fabioitturriet/32F769IDISCOVERY-Communication_with_ADS1198/ECG/TouchGFX/assets/images/__designer/Dark_Backgrounds_Main_bg_texture_480x272px.png

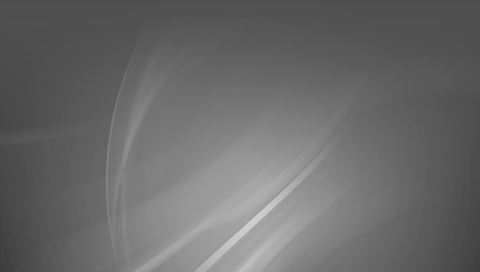
ECG/TouchGFX/assets/images/__designer/Dark_Backgrounds_Main_bg_texture_480x272px.png
