fabioitturriet/32F769IDISCOVERY-Communication_with_ADS1198/README.md

# Integração da Plataforma de desenvolvimento STM32F769IDISCO com o CI ADS1198
Autores: Fábio Itturriet e Patrick Morás
Data: 30/03/2022 
Versão: STM32CubeIDE 1.9.0 TouchGFX 4.19.0

_________________________________________________________________________________________________________________________________________________________________________________
# Importando o projeto

1. Faça download da pasta **ECG**, é preferível que ela seja salva na pasta raiz como C:\STM32Workspace\ECG.

Execute o STM32CubeIDE para importar o projeto

**Importante**: Ao selecionar o espaço de trabalho do CubeIDE, prefira por caminhos sem espaço pois podem gerar comflitos 
1. No CubeIDE vá atá a aba File > Import...
2. Selecione Existing Projects into Workspace > Next
3. Selecione Select root diretory > clique em browse... e selecione a pasta do projeto criado no touchGFX
4. Na área de "Projects:" será reconhecido o diretório do projeto para o STMCube, marque-o e clique em "Finish" 



Por ora, a integração esta completa, mas é interessante fazer algumas alterações para facilitar a manipulação do projeto. Para se ter um acesso direto ao arquivo do projeto da tela no cubeIDE, basta ir até a pasta que contém o projeto, acessar a pasta TouchGFX, clicar e segurar no executável do projeto, arrasta-lo para o cubeIDE e soltá-lo no projeto impotado na aba "Project Explorer"



Selecione "Link to files" e clique em "OK"



dessa maneira o executável do TouchGFX fica de fácil acesso para fazer alterações.

**Importante**: Ao compilar o código pode ocorrer erro como o da figura abaixo.



Isto ocorre pois a biblioteca do TouchGFX não está no mesmo caminho em que o projeto foi criado originalmente. Logo este caminho deve ser atualizado conforme o local da área de trabalho utilizada para importar o projeto. 
Para isto basta ir em Project -> Properties -> C/C++ General -> Paths and Symbols -> Library Paths, e alterar o caminho para a pasta /gcc do projeto 



### Configuração do Debugger

Antes de executar o código na plataforma deve configurar o Debugger. Com a plataforma conectada:

1. Execute o CubeIDE e vá na guia Run > Debugger configuration...
2. clique na aba Debugger e role até o final na janela
3. Marque "External Loader" e clique em scan
4. Por fim ao lado de Scan selecione a plataforma que esta sendo usada, aplique as configurações e feche a janela, ou execute o Debugger como desejado



Obs.: quando não feito esta configuração, ao executar o código a placa muitas vezes não é reconhecida adequadamente e sugem artefatos na tela assim como a falta de componentes graficos que deveriam estar lá.

### Importando uma GUI no TouchGFX 
 
 Abrindo o arquivo TouchGFX do projeto é possivel importar uma GUI ja existente em outro projeto
 1. Para isto basta ir na aba Edit > Import GUI 
 
 
 
 2. Clique em **Browse** e procure pelo arquivo que contém a GUI que se deja importar
 
 

3. Será exibido que ao importar a GUI atual será discartada e não será possível reverter esse processo, prossiga caso esteja seguro
4. Será indicado que a GUI importada possui alterações externas, basta clicar em Não nessa janela e finalmente temos a GUI importada, pode-se então gerar o código que será atualizado no projeto atual.

Ao importar a GUI de um outro projeto, como nesse exemplo, a função de importação importa apenas arquivos que estão localizados nas pastas gui/ e assets/. É importante destacar que para realizar a importação as versões dos projetos TouchGFX devem ser as mesmas, caso o projeto que se deseja importar está numa versão antiga do TouchGFX, para atualizado para nova versão basta abri lo com o TouchGFX e salva lo.

_________________________________________________________________________________________________________________________________________________________________________________
# Descrição dos pinos do ADS1198 conectados a plataforma versão 2.0

| Pino do ads1198 | Função (lado do ADS1198) | Descrição | Pino correspondente disco-F769NI |
| --- | --- | --- | --- |
| CLKSEL | entrada digital | Seleciona o fornecimento de clock principal (interno ou externo) | PB_14 (D12) |
| DRDY# | saída digital | Dados prontos, ativo baixo, depende do modo usado (RDATAC ou RDATA) | PF_6 (D3) |
| GPIO4 | saída/entrada digital | Pino de entrada / saída de uso geral configuráveis através de registradores; saida: registrador GPIOD define o valor da saída; entrada: multiplexado com o sinal de RESP_PH* (nao Configurado)| PB_15 (D11) |
| GPIO3 | saída/entrada digital | Pino de entrada / saída de uso geral configuráveis através de registradores; saida: registrador GPIOD define o valor da saída; entrada: multiplexado com o sinal RESP* (nao configurado) | PA_11 (D10) |
| GPIO2 | saída/entrada digital | Pino de entrada / saída de uso geral configuráveis através de registradores saida: registrador GPIOD define o valor da saída; entrada: multiplexado com sinal RESP_BLK* (nao configurado) | PH_6 (D9) |
| DOUT | saída digital | Saída de dados SPI, funciona juntamente com o SCLK | PF_8 (A4) SPI5_MISO |
| GPIO1 | saída/entrada digital | Pino de entrada / saída de uso geral configuráveis através de registradores saida: registrador GPIOD define o valor da saída; entrada: multiplexado com o sinal PACEIN* (nao configurado)| PJ_4 (D8) |
| DAISY_IN | Entrada digital | Utilizado quando se quer frontends funcionando em cadeia; curto com o DGND caso não utilizado | PC_8 (D5) |
| SCLK | Entrada digital | Clock SPI* | PF_7 (D6) SPI5_SCLK |
| CS# | Entrada digital | Seleção de chip para comunicação SPI,  ativo baixo durante toda a comunicação, após o fim da comunicação esperar pelo menos 8 ciclos de TCLK para subir o nível lógico, quando ocorrer a borda de subida a interface serial é reiniciada | PJ_0 (D4) |
| START | Entrada digital | Iniciar conversão, ativo alto por pelo menos dois TCLK, ou o comando START enviado para iniciar a conversão, sem o comando e o START em nível lógico baixo DRDY não emite sinal (conversões são interrompidas). utilizando o comando, o pino Start deve ficar em nivel lógico baixo (utilizado dessa maneira por enquanto). | curto com DGND |
| RESET# | Entrada digital | Reinicia o sistema, leva 18 ciclos para reiniciar (podendo voltar para o sinal alto), para reiniciar pode-se utilizar o comando RESET (entra em vigor na oitava borda descendente do SCLK) (utilizado o comando por enquanto) | PC_2 (A2) |
| PWDN# | Entrada digital | Desliga todos os circuitos do chip, é recomendado que durante o desligamento o relógio externo tbm seja desligado para economizar energia, | PA_4 (A1) |
| DIN | Entrada digital | Entrada de dados SPI* | PF_9 (A5) SPI5_MOSI |

_________________________________________________________________________________________________________________________________________________________________________________
## Alimentação

A alimentação digital (DVDD) tem 3,3V e a alimentação analógica (AVDD) tem 5V. Nesta configuração a tensão de referência fornecida ao integrado deve ser de 4V, ao contrário dos 2,4V recomendados para quando o CI é alimentado com tensão analógica menor do que 5V. Uma tensão de referencia maior faz com que resolução do CI diminua porém na tabela a seguir notamos que a tensão máxima de entrada digital no CI é de DVDD+0.1 V. Nesse sentido, a que a tensao digital utilizado na plataforma de desenvolvimento é 3.3V, para não ser necessário a utilização uma interface de regulação de tensao entre o CI e a plataforma foi utilizado, como ja comentado, 3,3V para alimentação digital o que resulta numa elevação da alimentação analógica (para 5V).



Em sintese AVDD foi definido como 5V e DVDD para 3.3V, dessa maneria não são necessários divisores de tensão na interface entre o ADS e o MCU, reduzindo a complexidade do circuito.

_________________________________________________________________________________________________________________________________________________________________________________
## Configurações

Foi utilizado o SPI5 para comunicação com o ADS, o clock fornecido para SPI5 é pelo barramento APB2 que pode ter 108 MHz (max).



O mínimo periodo para SCLK é 50ns, ou seja é um maximo de 20MHz de frequência, inicialmente foi utilizado o prescaler do SPI5 para diminuir a frequência 12.5MHz. No manual do ADS1198 também vemos outra configurações que devem ser feitas: NOTE: SPI settings are CPOL = 0 and CPHA = 1.



_________________________________________________________________________________________________________________________________________________________________________________
# Links importantes

https://www.youtube.com/watch?v=MUZj4YwKVac -> Adicionando biblioteca no cubeIDE

https://www.youtube.com/watch?v=x_5rYfAyqq0 -> SPI e DMA 

https://e2e.ti.com/support/data-converters-group/data-converters/f/data-converters-forum/252003/ads1298-signals-offset -> Ajuste de offset para cada canal

https://www.youtube.com/watch?v=Zqwq9nzTNF8 -> Recursos avançados de depuração: SWV

_________________________________________________________________________________________________________________________________________________________________________________
#  Versão 3.0

- Retirada do curto entre AVSS e DGND nos pinos 32 e 33 respectivamente.
- Pace_outP e Pace_outN expostos para processos de calibração
