fabioitturriet/32F769IDISCOVERY-Communication_with_ADS1198/ECG/TouchGFX/assets/images/local_eletrodos_corpo.png

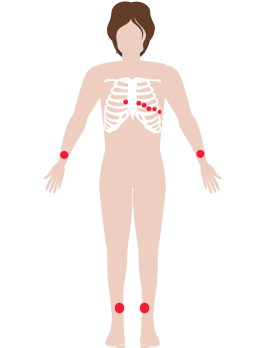
ECG/TouchGFX/assets/images/local_eletrodos_corpo.png
