fabioitturriet/32F769IDISCOVERY-Communication_with_ADS1198/ECG/TouchGFX/assets/images/VersaoVertical_resized.png

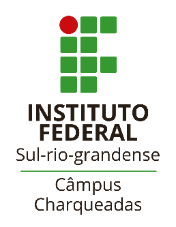
ECG/TouchGFX/assets/images/VersaoVertical_resized.png
