fabioitturriet/32F769IDISCOVERY-Communication_with_ADS1198/imgs/PCB_Frontend_ECG.png

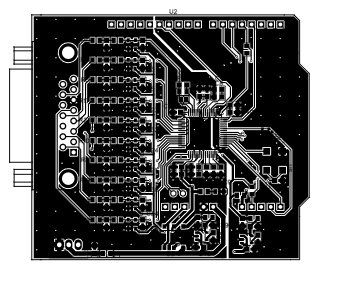
imgs/PCB_Frontend_ECG.png
