fabioitturriet/32F769IDISCOVERY-Communication_with_ADS1198/imgs/schematic_Frontend_ECG.png

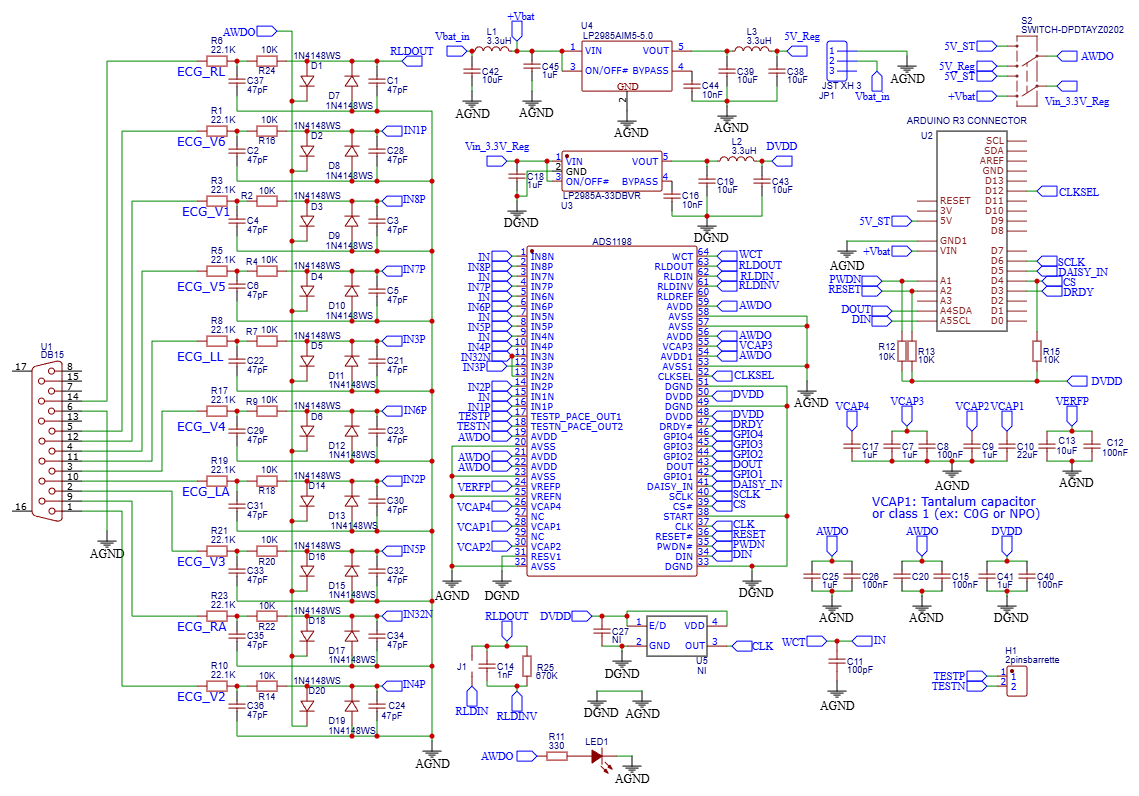
imgs/schematic_Frontend_ECG.png
