fabioitturriet/32F769IDISCOVERY-Communication_with_ADS1198/imgs/schematic_Frontend_ECG.pdf

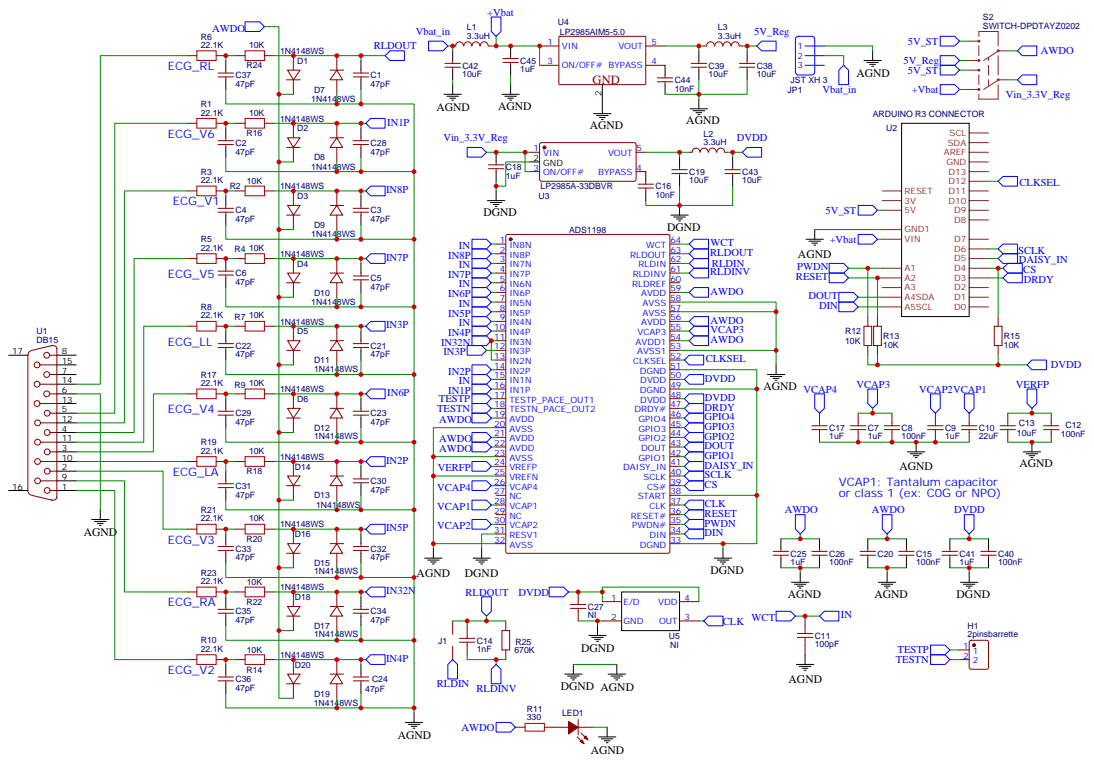
[picture p11: page 1]

VCAP1: Tantalum capacitor
or class 1 (ex: C0G or NPO)
AWDO
