fabioitturriet/32F769IDISCOVERY-Communication_with_ADS1198/ECG/STM32F769I_DISCO.ioc

Mcu.UserName=STM32F769NIHx
PA0/WKUP.Signal=GPXTI0
PA10.Signal=USART1_RX
PA4.GPIO_Label=PW_KEY
PA4.Signal=GPIO_Output
PA9.Signal=USART1_TX
PB14.GPIO_Label=ADS_CLKSEL
PB14.Signal=GPIO_Output
PB2.Signal=QUADSPI_CLK
PB3.Signal=SDMMC2_D2
PB4.Signal=SDMMC2_D3
PB6.Signal=QUADSPI_BK1_NCS
PB7.Signal=I2C4_SDA
PB8.Signal=GPIO_Output
PC10.Signal=QUADSPI_BK1_IO1
PC12.Signal=UART5_TX
PC2.GPIO_Label=ADS_RESET
PC2.Signal=GPIO_Output
PC8.GPIO_Label=ADS_DAISY
PC8.Signal=GPIO_Output
PC9.Signal=QUADSPI_BK1_IO0
PD0.Signal=FMC_D2_DA2
PD1.Signal=FMC_D3_DA3
PD10.Signal=FMC_D15_DA15
PD12.Signal=I2C4_SCL
PD13.Signal=QUADSPI_BK1_IO3
PD14.Signal=FMC_D0_DA0
PD15.Signal=FMC_D1_DA1
PD2.Signal=UART5_RX
PD6.Signal=SDMMC2_CK
PD7.Signal=SDMMC2_CMD
PD8.Signal=FMC_D13_DA13
PD9.Signal=FMC_D14_DA14
PE0.Signal=FMC_NBL0
PE1.Signal=FMC_NBL1
PE10.Signal=FMC_D7_DA7
PE11.Signal=FMC_D8_DA8
PE12.Signal=FMC_D9_DA9
PE13.Signal=FMC_D10_DA10
PE14.Signal=FMC_D11_DA11
PE15.Signal=FMC_D12_DA12
PE2.Signal=QUADSPI_BK1_IO2
PE7.Signal=FMC_D4_DA4
PE8.Signal=FMC_D5_DA5
PE9.Signal=FMC_D6_DA6
PF0.Signal=FMC_A0
PF1.Signal=FMC_A1
PF10.Signal=ADC3_IN8
PF11.Signal=FMC_SDNRAS
PF12.Signal=FMC_A6
PF13.Signal=FMC_A7
PF14.Signal=FMC_A8
PF15.Signal=FMC_A9
PF2.Signal=FMC_A2
PF3.Signal=FMC_A3
PF4.Signal=FMC_A4
PF5.Signal=FMC_A5
PF6.GPIO_Label=ADS_DRDY
PF6.Signal=GPXTI6
PF7.Signal=SPI5_SCK
PF8.Signal=SPI5_MISO
PF9.Signal=SPI5_MOSI
PG0.Signal=FMC_A10
PG1.Signal=FMC_A11
PG10.Signal=SDMMC2_D1
PG15.Signal=FMC_SDNCAS
PG4.Signal=FMC_A14_BA0
PG5.Signal=FMC_A15_BA1
PG8.Signal=FMC_SDCLK
PG9.Signal=SDMMC2_D0
PH0/OSC_IN.Signal=RCC_OSC_IN
PH1/OSC_OUT.Signal=RCC_OSC_OUT
PH10.Signal=FMC_D18
PH11.Signal=FMC_D19
PH12.Signal=FMC_D20
PH13.Signal=FMC_D21
PH14.Signal=FMC_D22
PH15.Signal=FMC_D23
PH2.Signal=FMC_SDCKE0
PH3.Signal=FMC_SDNE0
PH5.Signal=FMC_SDNWE
PH7.GPIO_Label=WIFI_CH_PD
PH7.Signal=GPIO_Output
PH8.Signal=FMC_D16
PH9.Signal=FMC_D17
PI0.Signal=FMC_D24
PI1.Signal=FMC_D25
PI10.Signal=FMC_D31
PI15.Signal=GPIO_Input
PI2.Signal=FMC_D26
PI3.Signal=FMC_D27
PI4.Signal=FMC_NBL2
PI5.Signal=FMC_NBL3
PI6.Signal=FMC_D28
PI7.Signal=FMC_D29
PI9.Signal=FMC_D30
PJ0.GPIO_Label=ADS_CS
PJ0.Signal=GPIO_Output
PJ1.GPIO_Label=FRAMERATE
PJ1.Signal=GPIO_Output
PJ13.GPIO_Label=VSYNC_FREQ2
PJ13.Signal=GPIO_Output
PJ14.GPIO_Label=WIFI_RST
PJ14.Signal=GPIO_Output
PJ15.GPIO_Label=DSI_RESET
PJ15.Signal=GPIO_Output
PJ2.Signal=DSIHOST_TE
PJ5.GPIO_Label=RENDER_TIME2
PJ5.Signal=GPIO_Output
