fabioitturriet/32F769IDISCOVERY-Communication_with_ADS1198/ECG/STM32CubeIDE/Application/User/biblioteca_ESP01/ESP8266.h

/*
 * ESP8266.h
 *
 *  Created on: Jan 10, 2023
 *      Author: Patrick
 */

#ifndef APPLICATION_USER_BIBLIOTECA_ESP01_ESP8266_H_
#define APPLICATION_USER_BIBLIOTECA_ESP01_ESP8266_H_

#include "stm32f7xx_hal.h"
#include "main.h"
#include <stdbool.h>


typedef enum
{
  AT_OK       = 0x00U,
  AT_ERROR    = 0x01U,
  AT_BUSY     = 0x02U
} AT_StatusTypeDef;


void ESP_init();

/*
 * Desliga o WIFI/ESP
 */
void WiFi_OFF();

/*Utiliza AT+CWLAP para buscar as redes dispíveis
 * Separa os nomes das redes e salva na struct Redes[]
 * Return o número de redes encontradas
 * Ex:
AT+CWLAP
+CWLAP:(0,"IF-PESQUISA-2.4GHz",-51,"d4:6e:0e:69:ee:f8",2,15)
+CWLAP:(0,"IF-07-TI",-89,"d4:6e:0e:69:e4:08",2,15)
+CWLAP:(0,"IF-09-ADMINISTRACAO",-83,"d4:6e:0e:69:ec:d0",10,15)

OK
Numero de redes: 3
IF-PESQUISA-2.4GHz
IF-07-TI
IF-09-ADMINISTRACAO
 */
int8_t BuscarRedes(char *CWLAPResponse);

void ConectarWiFi();

AT_StatusTypeDef transmitATcommand(const char *string);

AT_StatusTypeDef rodaComandoAT(char* comandoAT, uint32_t delay);

AT_StatusTypeDef VerificaErro(char *StringReceived, char *Marcacao);

void VerificaConexaoWiFi();

bool EsperarAte(char *StringReceived, char *Marcacao, uint16_t *ptr);

void ServerInit();

void constroijsonO(uint8_t type, char* status, int* ECGData, char* JSONBuffer, uint8_t PartePatch);

void requesthttp(uint8_t type, char* rota, char* host, char* accept, char* content_type, int length, char* json, char* RequestBuffer);

int size(int *valores);

void SendComandAT(char* comandoAT);

void ExtrairID(char* ESPRxData, char* IDobservation);

#endif /* APPLICATION_USER_BIBLIOTECA_ESP01_ESP8266_H_ */
